ameisso/BeachMachineV2/PCB/EspRemote.kicad_pcb

## KiCad design PCB/EspRemote.kicad_pcb (2025-01-19)

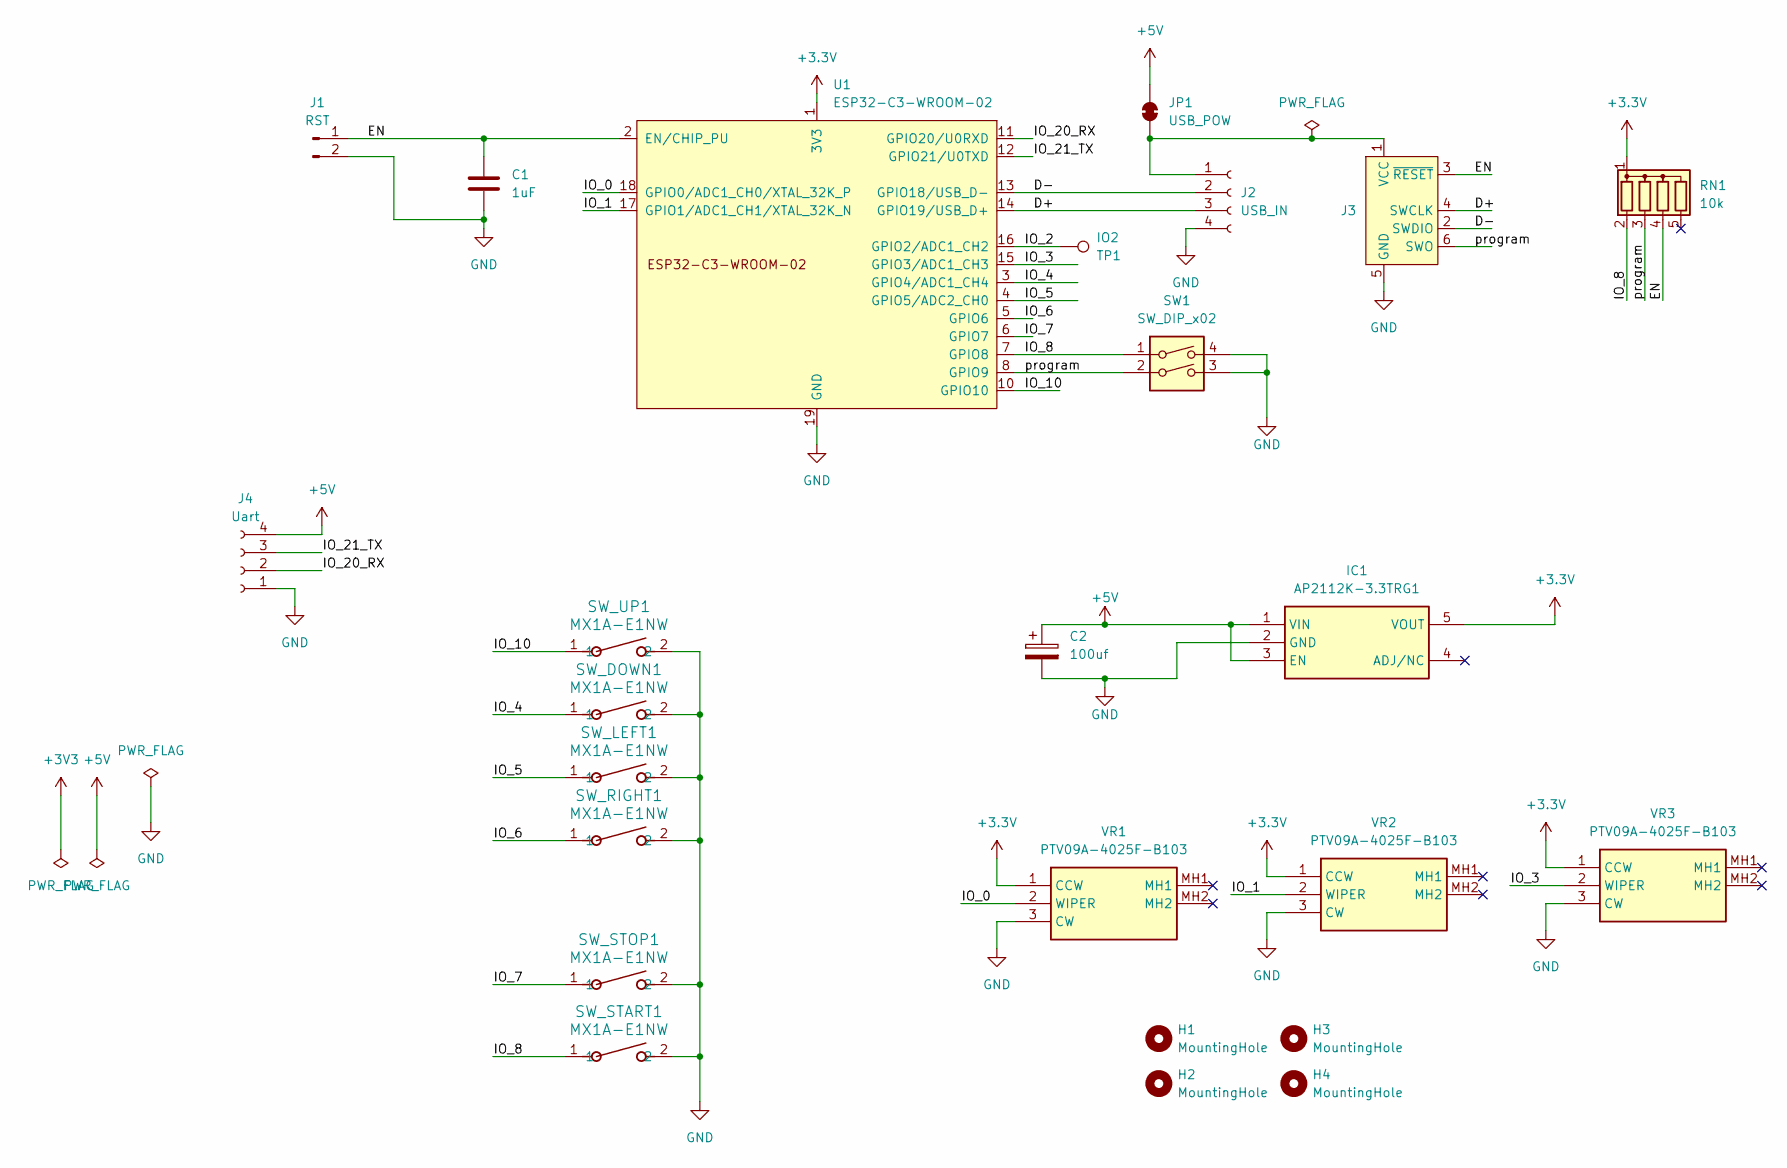
[picture p1: schematic EspRemote.kicad_sch]

Parts:
C1: 1uF; C_Rect_L7.2mm_W2.5mm_P5.00mm_FKS2_FKP2_MKS2_MKP2
C2: 100uf; CP_Radial_D8.0mm_P3.50mm
H1, H2, H3, H4: MountingHole; MountingHole_3.2mm_M3
IC1: AP2112K-3.3TRG1; SOT-23-5_handsoldering; Manufacturer_Part_Number AP2112K-3.3TRG1; Mouser Part Number 621-AP2112K-3.3TRG1
J1: RST; PinHeader_1x02_P2.54mm_Vertical
J2: USB_IN; PinHeader_1x04_P2.54mm_Vertical
J3: Conn_ARM_SWD_TagConnect_TC2030-NL; Tag-Connect_TC2030-IDC-NL_2x03_P1.27mm_Vertical
J4: Uart; KF301-4P screw terminal P5mm
JP1: USB_POW; SolderJumper-2_P1.3mm_Bridged_Pad1.0x1.5mm
RN1: 10k; R_Array_SIP5
SW1: SW_DIP_x02; SW_DIP_SPSTx02_Slide_9.78x7.26mm_W7.62mm_P2.54mm
SW_DOWN1: MX1A-E1NW; SW_Cherry_MX_1.00u_PCB
SW_LEFT1: MX1A-E1NW; SW_Cherry_MX_1.00u_PCB
SW_RIGHT1: MX1A-E1NW; SW_Cherry_MX_1.00u_PCB
SW_START1: MX1A-E1NW; SW_Cherry_MX_1.00u_PCB
SW_STOP1: MX1A-E1NW; SW_Cherry_MX_1.00u_PCB
SW_UP1: MX1A-E1NW; SW_Cherry_MX_1.00u_PCB
TP1: IO2; TestPoint_THTPad_1.0x1.0mm_Drill0.5mm
U1: ESP32-C3-WROOM-02
VR1, VR2, VR3: PTV09A-4025F-B103; PTV09A4015FB103; Manufacturer_Part_Number PTV09A-4025F-B103; Mouser Part Number 652-PTV09A-4025FB103

Connections:
+3.3V: IC1.5 (VOUT), RN1.1 (common), U1.1 (3V3), VR1.1 (CCW), VR2.1 (CCW), VR3.1 (CCW)
+5V: C2.1, IC1.1 (VIN), IC1.3 (EN), J4.4, JP1.2 (B)
/D+: J2.3, J3.4 (SWCLK), U1.14 (GPIO19/USB_D+)
/D-: J2.2, J3.2 (SWDIO), U1.13 (GPIO18/USB_D-)
/EN: C1.1, J1.1, J3.3 (~RESET), RN1.4 (R3), U1.2 (EN/CHIP_PU)
/IO_0: U1.18 (GPIO0/ADC1_CH0/XTAL_32K_P), VR1.2 (WIPER)
/IO_1: U1.17 (GPIO1/ADC1_CH1/XTAL_32K_N), VR2.2 (WIPER)
/IO_2: TP1.1, U1.16 (GPIO2/ADC1_CH2)
/IO_3: U1.15 (GPIO3/ADC1_CH3), VR3.2 (WIPER)
/IO_4: SW_DOWN1.1, U1.3 (GPIO4/ADC1_CH4)
/IO_5: SW_LEFT1.1, U1.4 (GPIO5/ADC2_CH0)
/IO_6: SW_RIGHT1.1, U1.5 (GPIO6)
/IO_7: SW_STOP1.1, U1.6 (GPIO7)
/IO_8: RN1.2 (R1), SW1.1, SW_START1.1, U1.7 (GPIO8)
/IO_10: SW_UP1.1, U1.10 (GPIO10)
/IO_20_RX: J4.2, U1.11 (GPIO20/U0RXD)
/IO_21_TX: J4.3, U1.12 (GPIO21/U0TXD)
/program: J3.6 (SWO), RN1.3 (R2), SW1.2, U1.8 (GPIO9)
GND: C1.2, C2.2, IC1.2 (GND), J1.2, J2.4, J3.5 (GND), J4.1, SW1.3, SW1.4, SW_DOWN1.2, SW_LEFT1.2, SW_RIGHT1.2, SW_START1.2, SW_STOP1.2, SW_UP1.2, U1.9 (GND), U1.19 (GND), VR1.3 (CW), VR2.3 (CW), VR3.3 (CW)
unnamed: J2.1, J3.1 (VCC), JP1.1 (A)

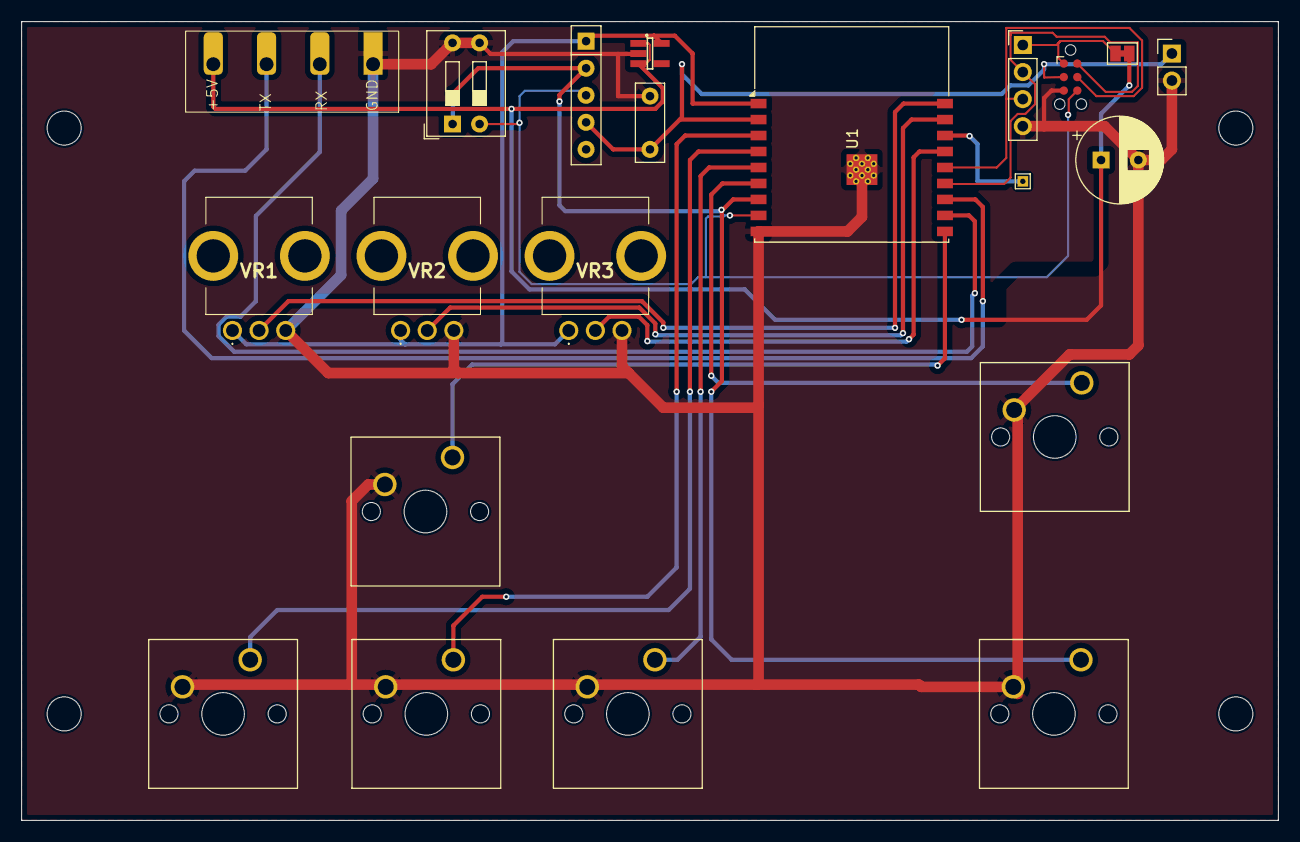
[picture p2: board EspRemote.kicad_pcb from above]

Board: 2 copper layers, 118.0 x 75.0 mm, 25 parts (0 on the bottom side), 20 nets.
