ameisso/BeachMachineV2/Code/fluidNCRemote/ConfigFiles/k40.yaml

board: MKS-DLC32
name: BeachMachine
meta: V0_ameisso
kinematics: {}
stepping:
  engine: I2S_STATIC
  idle_ms: 254
  pulse_us: 6
  dir_delay_us: 10
  disable_delay_us: 0
axes:
  shared_stepper_disable_pin: i2so.0
  x:
    steps_per_mm: 100
    max_rate_mm_per_min: 5000
    acceleration_mm_per_sec2: 1000
    max_travel_mm: 2000
    soft_limits: false
    motor0:
      limit_neg_pin: NO_PIN
      hard_limits: false
      pulloff_mm: 1
      stepstick:
        step_pin: I2SO.1
        direction_pin: I2SO.2:low
      limit_pos_pin: NO_PIN
      limit_all_pin: NO_PIN
  y:
    steps_per_mm: 100
    max_rate_mm_per_min: 5000
    acceleration_mm_per_sec2: 1000
    max_travel_mm: 2000
    soft_limits: false
    motor0:
      limit_neg_pin: NO_PIN
      hard_limits: false
      pulloff_mm: 1
      stepstick:
        step_pin: I2SO.5
        direction_pin: I2SO.6:high
      limit_pos_pin: NO_PIN
      limit_all_pin: NO_PIN
    motor1:
      limit_neg_pin: NO_PIN
      hard_limits: false
      pulloff_mm: 1
      stepstick:
        step_pin: I2SO.3
        direction_pin: I2SO.4
      limit_pos_pin: NO_PIN
      limit_all_pin: NO_PIN
  z:
    steps_per_mm: 100
    max_rate_mm_per_min: 5000
    acceleration_mm_per_sec2: 100
    max_travel_mm: 2
    soft_limits: false
    motor0:
      rc_servo:
        pwm_hz: 50
        output_pin: gpio.22
        min_pulse_us: 2000
        max_pulse_us: 1000
i2so:
  bck_pin: gpio.16
  data_pin: gpio.21
  ws_pin: gpio.17
spi:
  miso_pin: gpio.12
  mosi_pin: gpio.13
  sck_pin: gpio.14
sdcard:
  cs_pin: gpio.15
  card_detect_pin: gpio.39
control:
  safety_door_pin: NO_PIN
  reset_pin: gpio.33:pu:low
  feed_hold_pin: NO_PIN
  cycle_start_pin: NO_PIN
  macro0_pin: NO_PIN
  macro1_pin: NO_PIN
  macro2_pin: NO_PIN
  macro3_pin: NO_PIN
  fault_pin: NO_PIN
  estop_pin: NO_PIN
macros:
  macro0: $SD/Run=lasertest.gcode
  macro1: $SD/Run=home.gcode
coolant:
  flood_pin: NO_PIN
  mist_pin: NO_PIN
  delay_ms: 0
user_outputs:
  analog0_pin: NO_PIN
  analog1_pin: NO_PIN
  analog2_pin: NO_PIN
  analog3_pin: NO_PIN
  analog0_hz: 5000
  analog1_hz: 5000
  analog2_hz: 5000
  analog3_hz: 5000
  digital0_pin: NO_PIN
  digital1_pin: NO_PIN
  digital2_pin: NO_PIN
  digital3_pin: NO_PIN
start:
  must_home: true
uart1:
  txd_pin: gpio.0
  rxd_pin: gpio.4
  baud: 115200
  mode: 8N1
uart_channel1:
  uart_num: 1
  report_interval_ms: 5000
  message_level: verbose
