ameisso/BeachMachineV2/Code/fluidNCRemote/src/pinUtils.h

#define UP_PIN 10
#define DOWN_PIN 4
#define LEFT_PIN 5
#define RIGHT_PIN 6

#define ZERO_PIN 7
#define PLAY_PIN 8

#define POT_1_PIN 0
#define POT_2_PIN 1 
#define POT_3_PIN 3
