ameisso/BeachMachineV2/(commit log)

2025-01-19 New : first pcb batch
    [EspRemote.kicad_pcb, EspRemote.kicad_sch, bom.csv, designators.csv, positions.csv]
2025-01-19 New : config Files
    [k40.yaml]
2025-01-22 New : program loop
    [k40.yaml]
2025-02-08 New : wiring manual
2025-02-08 New : Servo + Dual Y out
    [k40.yaml]
2025-02-08 Fix : soft limit and servo range
    [k40.yaml]
2025-02-10 New : config file v2
    [k40.yaml]
2025-02-10 Fix : steps/mm
    [k40.yaml]
2025-02-10 New : release alarms
    [k40.yaml]
2025-02-11 Fix : startup offset for servo
    [main.cpp]
2025-02-11 New : restart controller at zero (to ensure Z machine position at 0)
    [k40.yaml]
2025-02-11 New : button handler structure
2025-02-16 New : first pcb buildup code
2025-02-16 Fix : reconnect wifi on play
    [main.cpp]
2025-02-16 Refactor : telnet prints
2025-02-16 Refactor : prints
